k22rs012/BachelorThesis/10thanks.tex

本研究の遂行および本論文の執筆にあたり，多大なるご指導とご支援を賜りました九州産業大学理工学部情報科学科の田中康一郎教授に，心より感謝申し上げます．研究の進め方のみならず，問題に対する考え方や研究者としての姿勢についても多くのことをご教示いただきました．日々の議論や助言を通して，研究に対する視野を広げる貴重な機会を与えていただいたことに，深く感謝しております．

また，2 年間にわたり同じ研究室に所属し，ともに研究活動に取り組んだ学部 4 年の青柳貴之氏，上原一眞氏，木村光翔氏，須賀翔一氏，竹内勇人氏，平田健斗氏，嶺田あんず氏には，心から感謝いたします．研究が思うように進まない時期においても，互いに意見を交換し，励まし合いながら研究を進めることができたことは，本研究を完成させる上で大きな支えとなりました．日々の研究活動を通して，多くの刺激を受け，ともに成長できたことを大変嬉しく思います．

さらに，学部 3 年の阿比留新太氏，彌永大翔氏，岡野望生氏，熊添翠杏氏，佐藤乃果氏，島崎佑亮氏，野坂卓矢氏，日高祥平氏には，測定実験やデータ整理など，研究活動のさまざまな場面において多大な協力をいただきました．忙しい中にもかかわらず，快く研究を手伝っていただいたことに，深く感謝いたします．皆様の協力なくして，本研究を円滑に進めることはできませんでした．

最後に，大学 4 年間にわたり，経済的にも精神的にも支えてくれた家族に心から感謝します．研究や学業に集中できる環境を与えてくれたこと，そして常に温かく見守り続けてくれたことに，深く感謝しております．

\begin{flushright}
2026/1

井上誠斗
\end{flushright}
