k22rs012/BachelorThesis/figures/akamura_co2_height.png

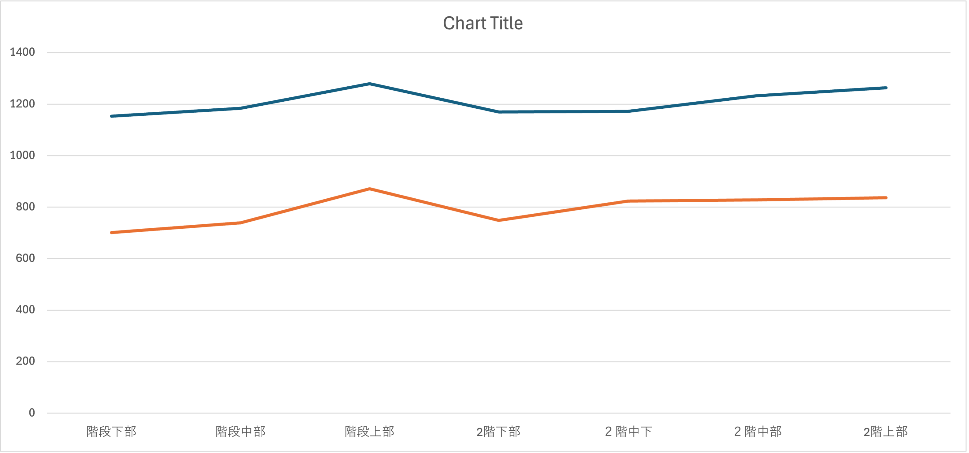
figures/akamura_co2_height.png
