k22rs012/BachelorThesis/MaterialsFile/Image/Image (4).jpeg

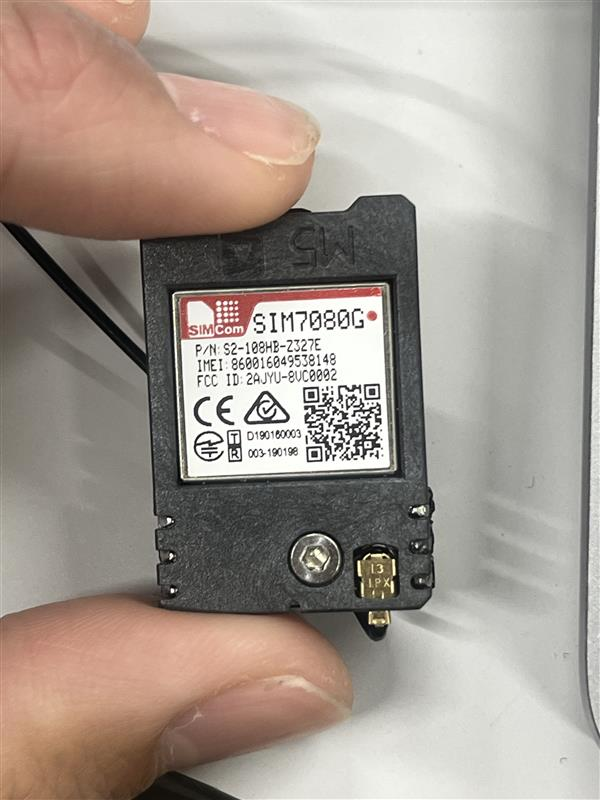
MaterialsFile/Image/Image (4).jpeg
