k22rs012/BachelorThesis/MaterialsFile/Image/Image (5).jpeg

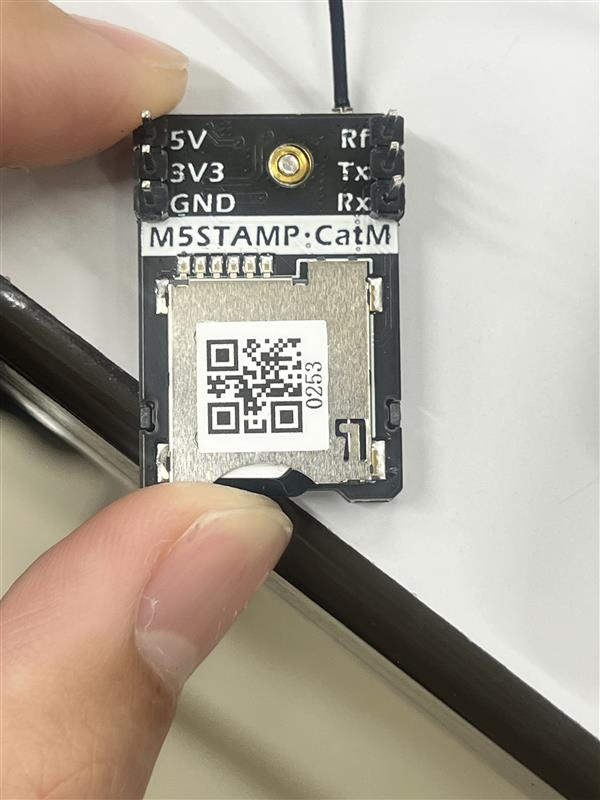
MaterialsFile/Image/Image (5).jpeg
