k22rs012/BachelorThesis/MaterialsFile/Image/Image (6).jpeg

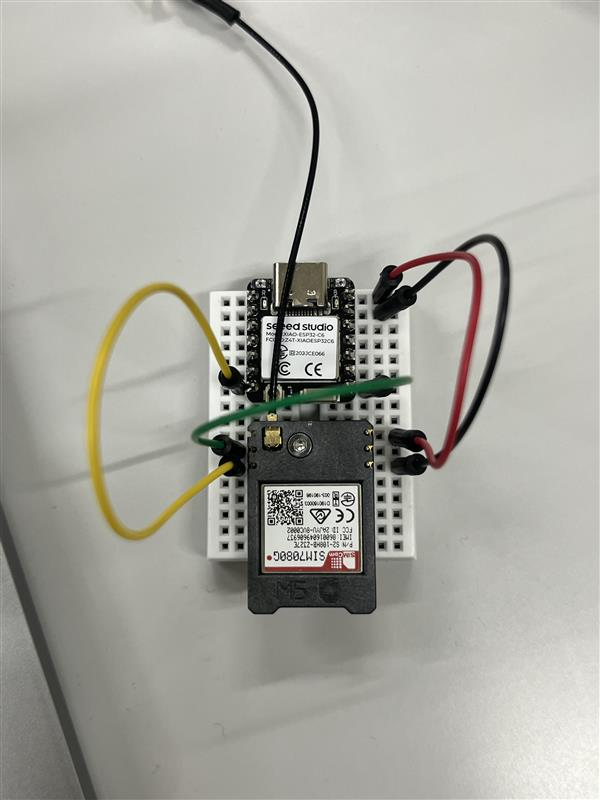
MaterialsFile/Image/Image (6).jpeg
