k22rs012/BachelorThesis/MaterialsFile/Image/Image (17) (1).jpeg

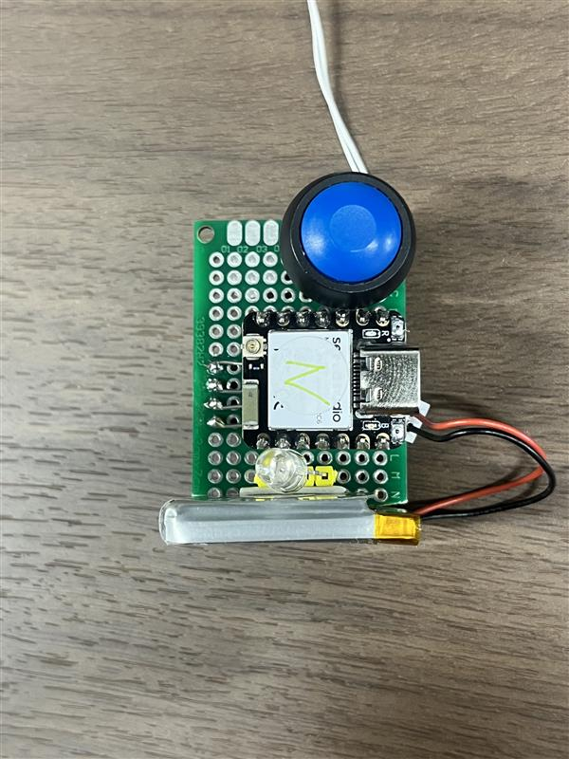
MaterialsFile/Image/Image (17) (1).jpeg
