k22rs012/BachelorThesis/MaterialsFile/Image/Image (19) (1).jpeg

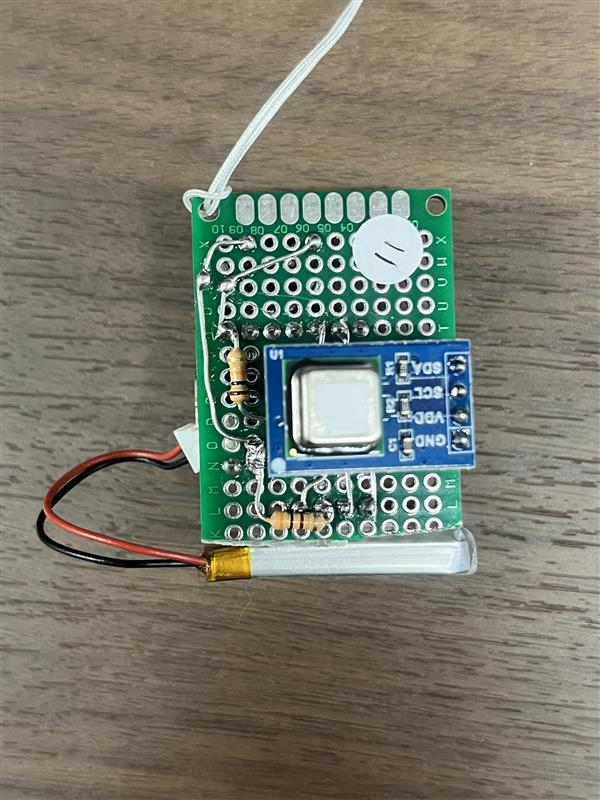
MaterialsFile/Image/Image (19) (1).jpeg
