k22rs012/BachelorThesis/MaterialsFile/Image/LTE_siasaku.jpeg

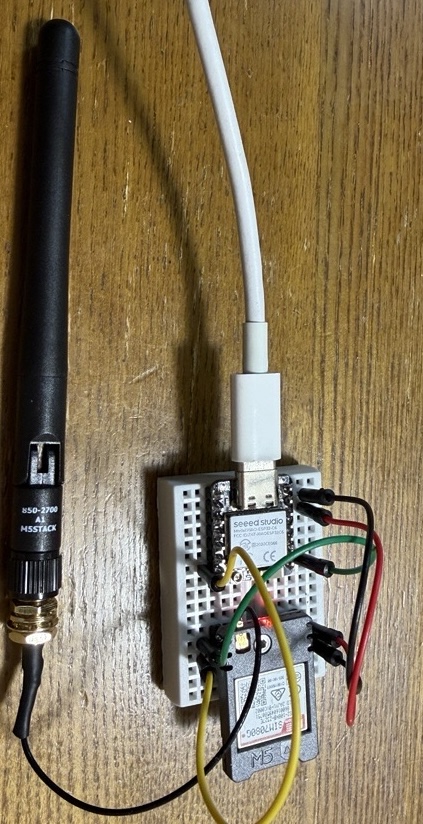
MaterialsFile/Image/LTE_siasaku.jpeg
