k22rs012/BachelorThesis/MaterialsFile/Image/mune.jpeg

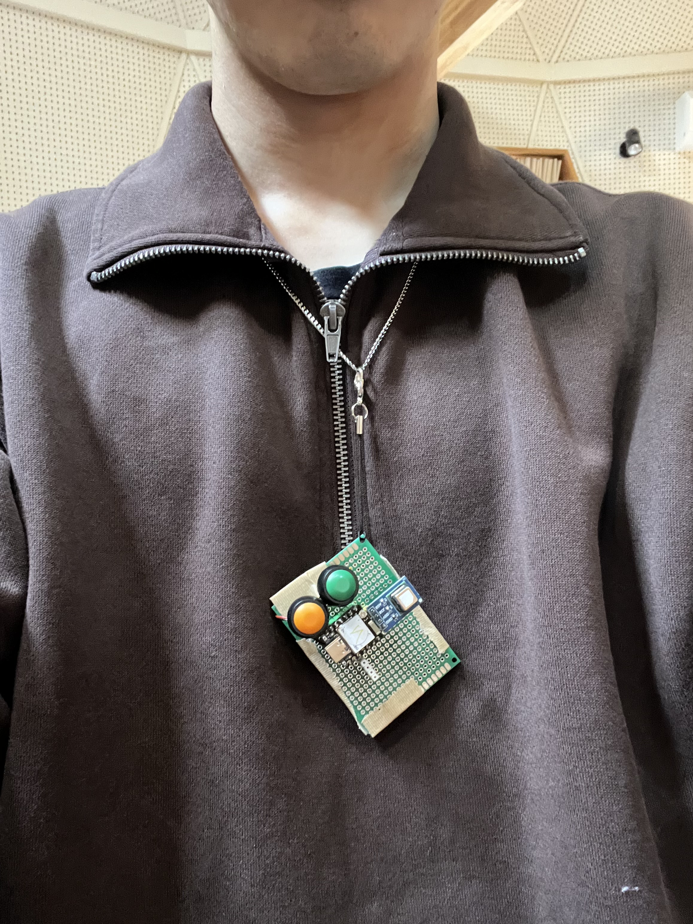
MaterialsFile/Image/mune.jpeg
