k22rs012/BachelorThesis/MaterialsFile/Image/Picture1.png

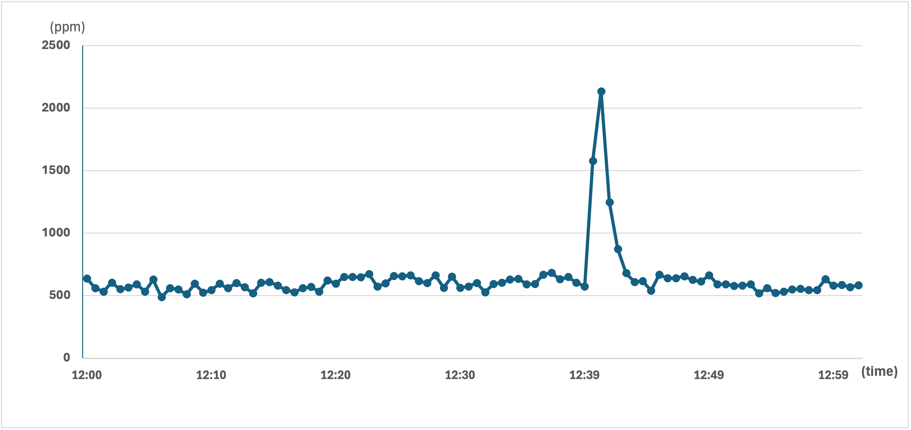
MaterialsFile/Image/Picture1.png
