k22rs012/BachelorThesis/MaterialsFile/Image/sisakuki_1.jpeg

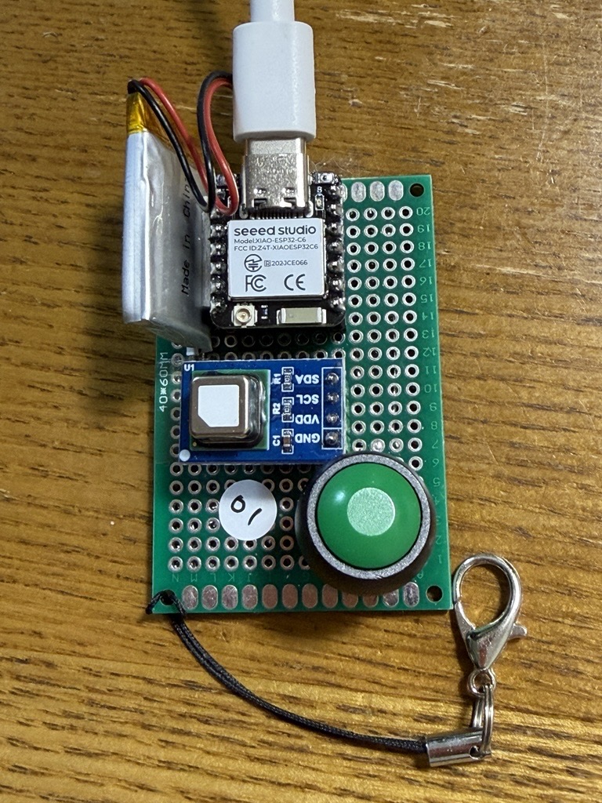
MaterialsFile/Image/sisakuki_1.jpeg
