k22rs012/BachelorThesis/MaterialsFile/Image/sisakuki_1_ura.jpeg

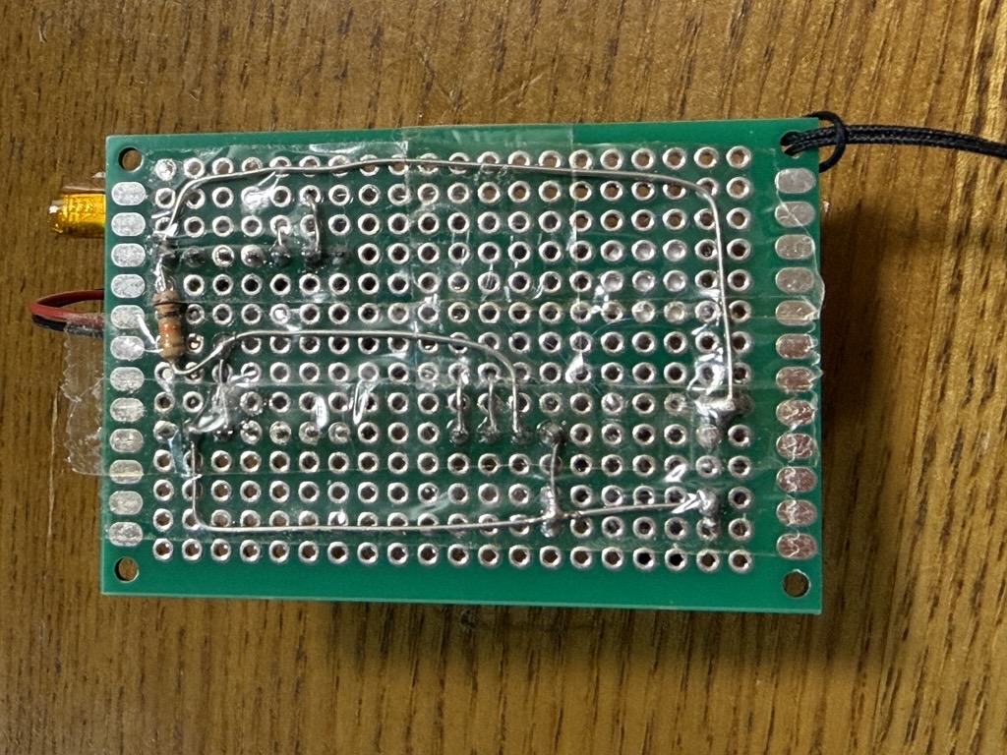
MaterialsFile/Image/sisakuki_1_ura.jpeg
