k22rs012/BachelorThesis/MaterialsFile/Image/電車内.png

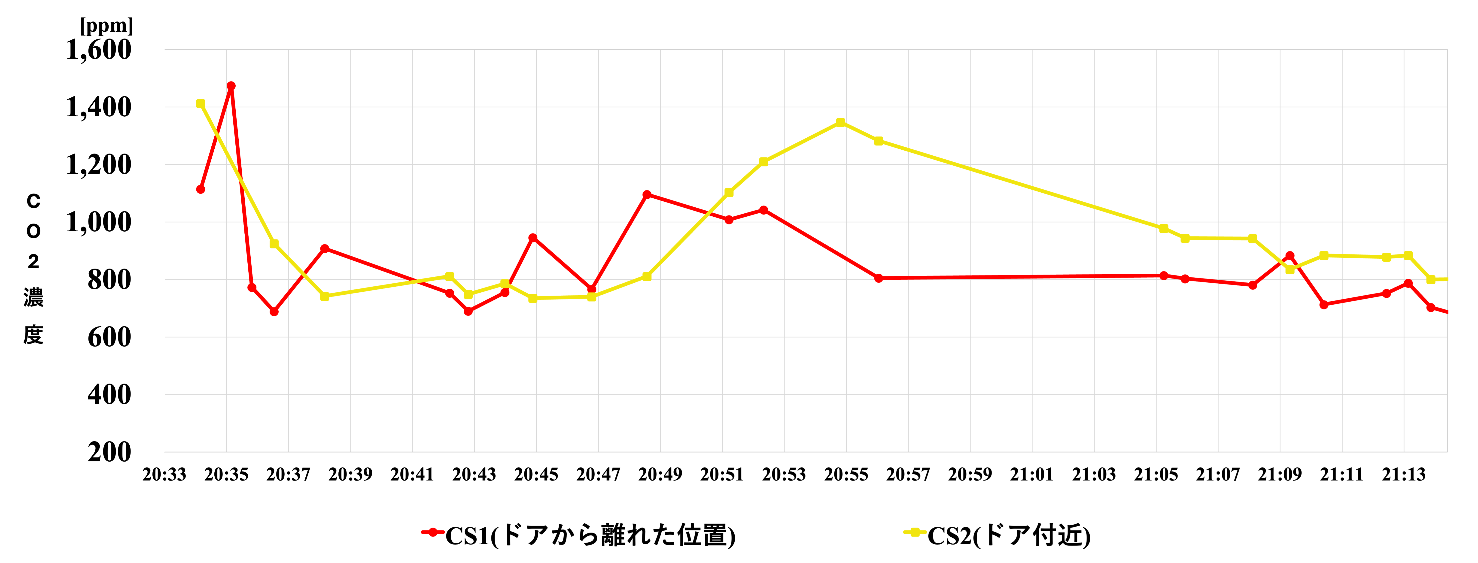
MaterialsFile/Image/電車内.png
