k22rs012/BachelorThesis/AirVelocitySensorBreakout-EagleFiles/SparkFun_Qwiic_FS3000_1X1.brd

## EAGLE design AirVelocitySensorBreakout-EagleFiles/SparkFun_Qwiic_FS3000_1X1.brd (2025-12-17)

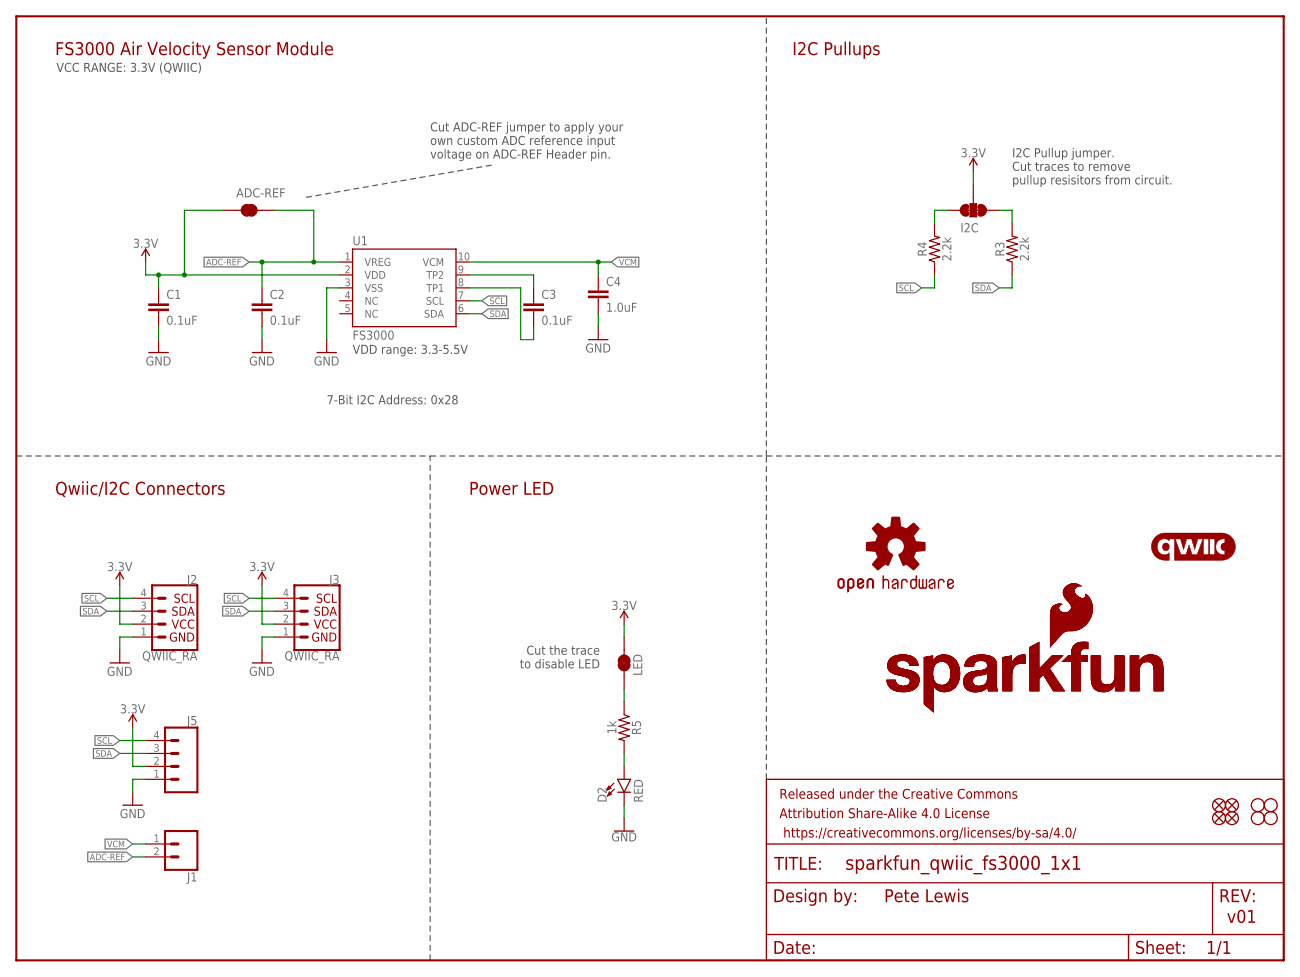
[picture p16: schematic SparkFun_Qwiic_FS3000_1X1.sch]

Parts:
ADC-REF: JUMPER-SMT_2_NC_TRACE_SILK; SMT-JUMPER_2_NC_TRACE_SILK
C1, C2, C3: 0.1uF; 0402-TIGHT
C4: 1.0uF; 0402-TIGHT
D2: RED; LED-0603
FRAME1: FRAME-LETTER; CREATIVE_COMMONS
I2C: JUMPER-SMT_3_2-NC_TRACE_SILK; SMT-JUMPER_3_2-NC_TRACE_SILK
J1: CONN_021X02_NO_SILK; 1X02_NO_SILK
J2, J3: QWIIC_RA; JST04_1MM_RA
J5: CONN_041X04_NO_SILK; 1X04_NO_SILK
JP1: LED; SMT-JUMPER_2_NC_TRACE_SILK
JP2, JP5, JP6, JP11: FIDUCIALUFIDUCIAL; FIDUCIAL-MICRO
JP3, JP4, JP7, JP8: STAND-OFF
LOGO1: OSHW-LOGOMINI; OSHW-LOGO-MINI
LOGO3, LOGO5: SFE_LOGO_NAME_FLAME.1_INCH; SFE_LOGO_NAME_FLAME_.1
LOGO4: QWIIC_LOGO_5MM; QWIIC_5MM
R3, R4: 2.2k; 0402-TIGHT
R5: 1k; 0402-TIGHT
U1: FS3000

Connections:
3.3V: ADC-REF.1, C1.1, I2C.2, J2.2, J3.2, J5.2, JP1.2, U1.2 (VDD)
ADC-REF: ADC-REF.2, C2.1, J1.2, U1.1 (VREG)
GND: C1.2, C2.2, C4.2, D2.C, J2.1, J3.1, J5.1, U1.3 (VSS)
unnamed: I2C.1, R3.2
unnamed: I2C.3, R4.2
unnamed: C3.1, U1.9 (TP2)
unnamed: C3.2, U1.8 (TP1)
unnamed: D2.A, R5.2
unnamed: JP1.1, R5.1
SCL: J2.4, J3.4, J5.4, R4.1, U1.7 (SCL)
SDA: J2.3, J3.3, J5.3, R3.1, U1.6 (SDA)
VCM: C4.1, J1.1, U1.10 (VCM)

Notes on the sheet:
7-Bit I2C Address: 0x28
Pete Lewis
v01
FS3000 Air Velocity Sensor Module
Qwiic/I2C Connectors
I2C Pullup jumper. Cut traces to remove pullup resisitors from circuit.
Cut the trace to disable LED
Power LED
VCC RANGE: 3.3V (QWIIC)
I2C Pullups
Cut ADC-REF jumper to apply your own custom ADC reference input voltage on ADC-REF Header pin.
VDD range: 3.3-5.5V

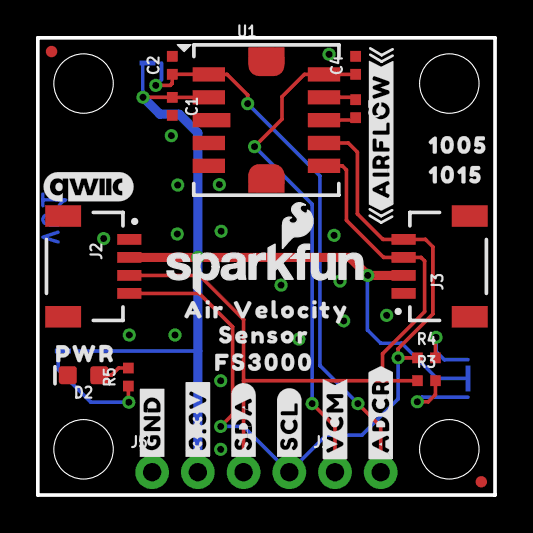
[picture p17: board SparkFun_Qwiic_FS3000_1X1.brd from above]

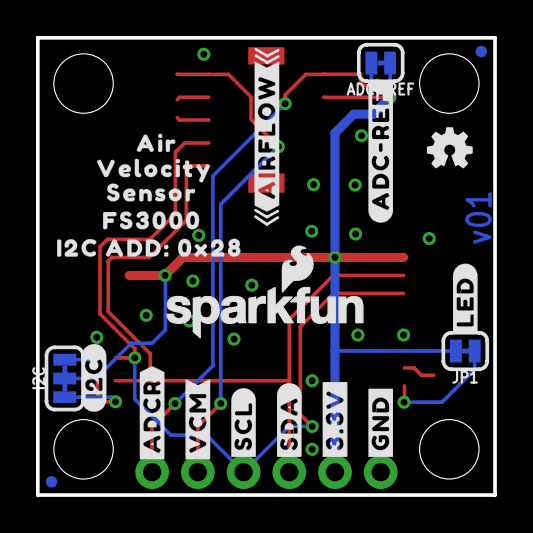
[picture p18: board SparkFun_Qwiic_FS3000_1X1.brd from below]

Board: 2 copper layers, 25.4 x 25.4 mm, 58 parts (22 on the bottom side), 12 nets.

Other parts of the board:
U$3, U$11: #SCL#0
U$4, U$9: #SDA#0
U$5, U$6: #GND#0
U$7, U$8: #3#3V#0
U$10, U$13: #ADCR#4
U$12: 10050
U$14, U$17: FS30001
U$15: #ADC#REF#0
U$16, U$20: VELOCITY30003
U$18, U$21: AIR30004
U$19, U$22: SENSOR30005
U$23, U$26: #AIRFLOW#0
U$24: #LED#0
U$25: PWR0
U$27: #I2C#0
U$28: I2C_ADD#_0X280
U$29: 10150
U$30, U$31: #VCM#3
