k22rs012/BachelorThesis/(commit log)

2026-01-08 2章の変更
2026-01-08 ４章の変更
2026-01-08 ５章の変更
2026-01-08 第２章開発環境
2026-01-08 ４章変更
2026-01-08 ２章変更
2026-01-08 Update 7measurementMethod.tex
    表記順の変更
